micronano0/zwitscherbox/001_0_zwitscherbox_schaltplan.jpg

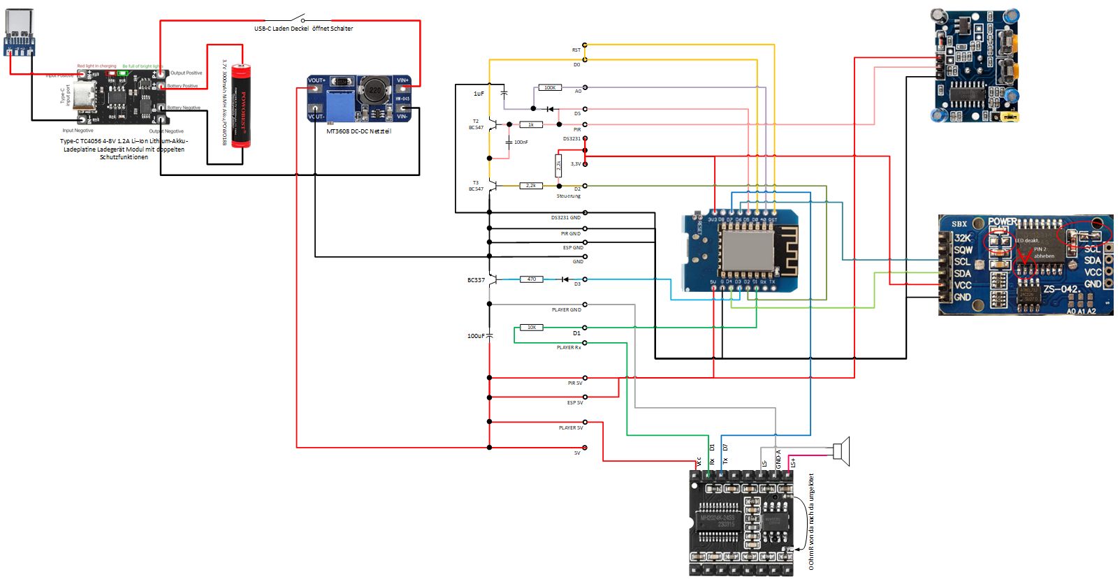
001_0_zwitscherbox_schaltplan.jpg
