micronano0/zwitscherbox/001_1_schematic_zwitscherbox_easyeda.png

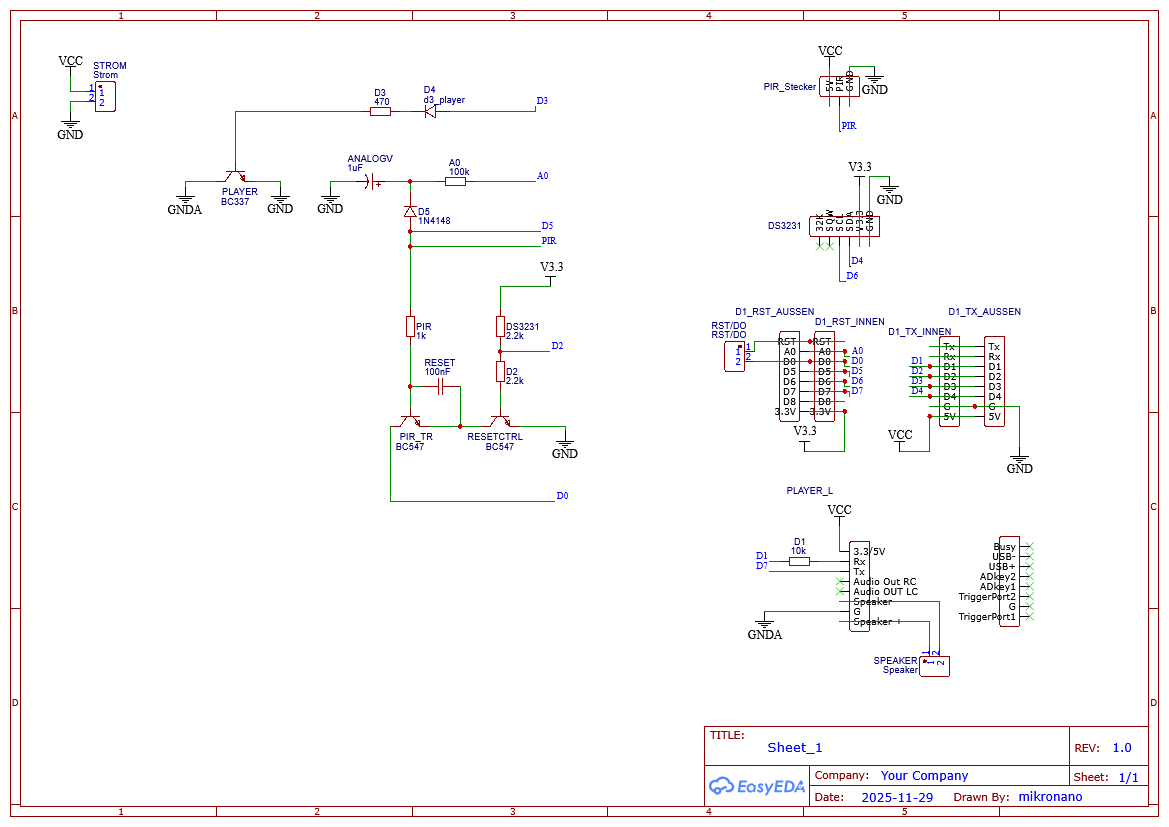
001_1_schematic_zwitscherbox_easyeda.png
